ddjoyce2019/Automated-Latte-Art/8B5924DC-6238-43FC-8603-331274C20421_1_106_c.jpeg

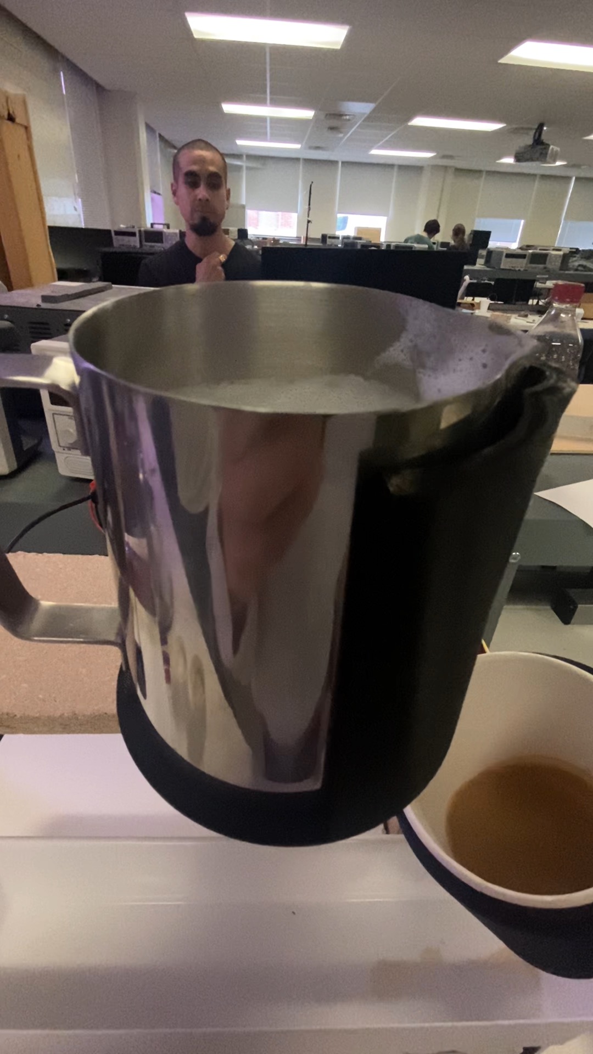
8B5924DC-6238-43FC-8603-331274C20421_1_106_c.jpeg
