ddjoyce2019/Automated-Latte-Art/README.md

# Automated-Latte-Art
Senior Capstone Project: Automated Latte Art Machine
