ddjoyce2019/Automated-Latte-Art/Design Timing.docx

Heart

Tilt Coffee Cup - 30-45 degrees

Lift milk 7-8cm and slowly poor
