ddjoyce2019/Automated-Latte-Art/4.11 Week Plan.docx

**Work on PowerPoint all week whenever is convenient**

*Come in whenever you're available*

MONDAY

- Exhausted exhausted

TUESDAY

- Get heart working til recognizable

WEDNESDAY

- Tulip making blobs

THURSDAY

- Tulip

FRIDAY

- Fern
- GUI

SUNDAY

- Bucket
- Finish fern
- Powerpoint FINISHED

MONDAY

- Demo so hopefully nothing
