ddjoyce2019/Automated-Latte-Art/Flowcharts.pptx

GUI Flowchart

Start

Main Menu

Design One

Design Two

Start

Loading Screen

Run code controlling hardware based on designType

Is hardware program done?

Exit

Has user clicked Design 1 or 2

designType == Design User clicked

End

designType == Design 1

No

Yes

No

Yes

## Slide 2

Actuator Flowchart

Start

Initial actuator location

Signal from GUI received?

Start signal

No

Yes

Exit signal

Actuator 1 Thread

Actuator 2 Thread

End

## Slide 3

Motor Flowchart

Start

Initial position

Signal from GUI received?

Start signal

No

Yes

Exit signal

Servo 1 Thread

Servo 2 Thread

Actuator 1 Thread

Actuator 2 Thread

End
