ddjoyce2019/Automated-Latte-Art/Ideas for Project.docx

- Light following solar pane l- - -
- Recycling sorter - -
- Flood indicator
- Card shuffler and dealer- – - - -
  - Blackjack: can use CV to detect the cards and alert when one player reaches 21 or busts etc
- Phone controlled wheel chair -
- Lie Detector -
- Latte maker- - - - -
- Rubix cube solver– - -
- Coin counter
- Sign language glove- - - - -
- Wire cutter + stripper machine- -
- Card shuffler/dealer
  - Take a deck of cards and shuffle into a predetermined order?
- Latte Maker
  - Create latte art
- Rubix Cube Solver
- Sign Language Glove
  - translate the alphabet

Ask about project manager

Raspberry pi

Purchasing process
