ddjoyce2019/Automated-Latte-Art/Milestone 1.pptx

## Lazy Latte Art

Build a latte art machine by April 17, 2023 for $450
Integrated Systems Design II: Milestone 1 Demo
Elise Ferkler, Mariah Tam, Derrick Joyce, Jackie Bendziewicz, Leah Brown, Luke Swetonic
Electrical and Computer Engineering
Clemson University

## Block Diagram


## GUI Flow Chart

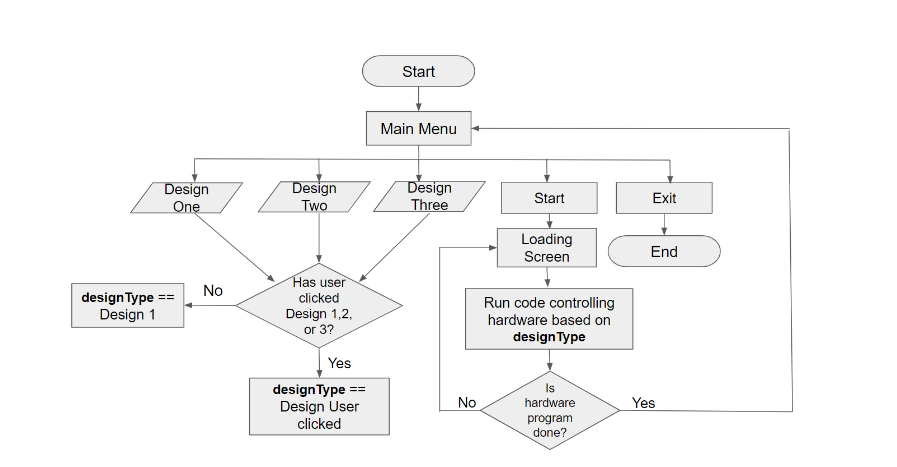
[picture p11: figure]

## Actuator Control Flow Chart

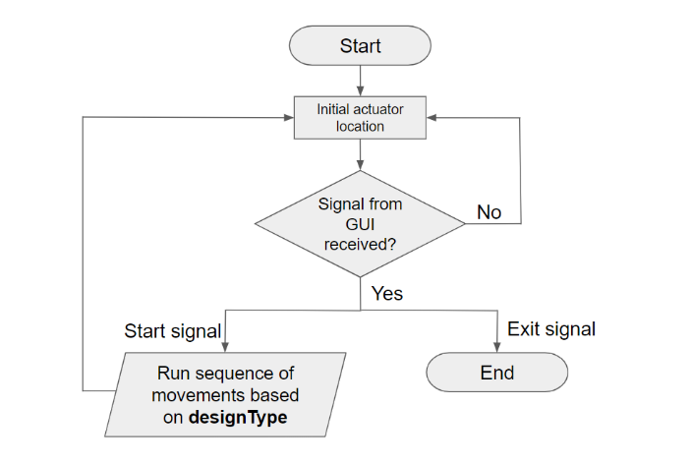
[picture p12: figure]

## Motor Control Flow Chart

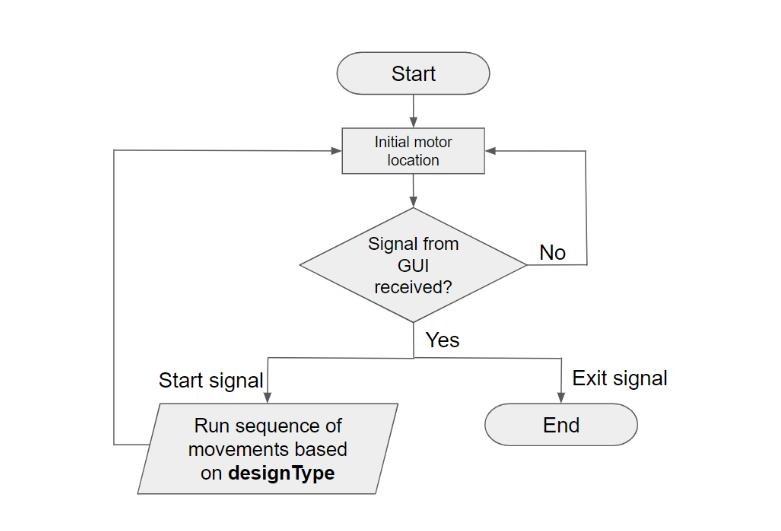
[picture p13: figure]

## Claimed Deliverables

- Create first draft of physical design
- Program the 2 linear actuators and 2 servos to move simultaneously
- Program the coffee cup servo to rotate from 0 to 45 degrees
- Program the milk cup servo to rotate from 0 to 150 degrees
- Program the vertical linear actuator to move up 4 inches
- Program the horizontal linear actuator to move right 3 inches

## Implemented Prototype

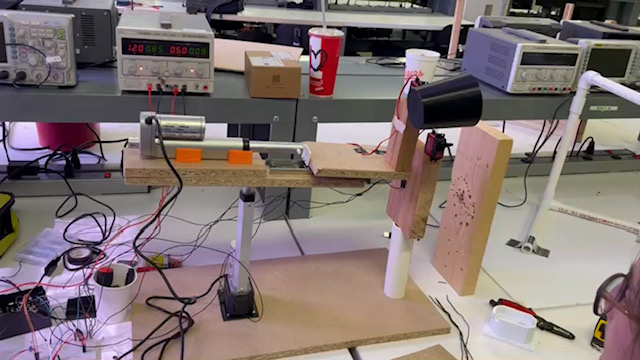
[picture p14: figure]

## Challenges/Bottlenecks

- Twitching servo motors
- Precise control of linear actuators
- Speed of linear actuators
