ddjoyce2019/Automated-Latte-Art/Python Modules.docx

Python Modules

App development

- kivy

Resources:

https://www.section.io/engineering-education/kivy-python-first-app/

https://www.geeksforgeeks.org/kivy-tutorial/

Raspberry Pi Connections

https://medium.com/geekculture/gpio-programming-on-the-raspberry-pi-python-libraries-e12af7e0a812

- RPi.GPIO

Resources:

https://www.ics.com/blog/control-raspberry-pi-gpio-pins-python

https://pythonprogramming.net/gpio-raspberry-pi-tutorials/

-gpiozero
Resources:

https://gpiozero.readthedocs.io/en/stable/

Motor controls

Actuator Controls
