ddjoyce2019/Automated-Latte-Art/Weekly Progress Report - April 10.docx

Intelligent System Design II

Electrical and Computer Engineering

Clemson University

Weekly Progress Report and Planning Sheet

Lazy Latte Art

Leah Brown, Luke Swetonic, Jacqueline Bendziewicz, Mariah Tam, Elise Ferkler, Derrick Joyce

Week of: April 10, 2023

Activities Completed This week (bullet points):

- Integrated GUI
- Stabilized base
- Worked on heart design
- Started work on Tulip design

Student (update) | Individual Accomplishment(s)/Effort(s) contributing to Team Efforts | PMP sync?*
Luke | Helped change the heart design to pour a better design, helped with some physical design issues. | yes
Elise | Helped modify the heart design, helped stabilize physical design, and started fixing Tulip design | yes
Leah | Helped with testing the heart design with coffee and fix program for tulip | yes
Jackie | Helped modify heart design, helped stabilize physical design and fix wires and breadboard in place | yes
Mariah | Integrated the GUI into the design code, helped modify heart design, helped stabilize the physical design. | yes
Derrick | Cut pieces for physical design, helped integrate GUI with hardware code, helped with heart design | yes

* Please answer as Yes, No or Ahead, which represent on-schedule, late and ahead-of-schedule progress with respect to the PMP.

Activities in Progress (bullet points):

- Continue working on heart and tulip designs
- Continue working on casing
- Continue to update GUI

Activities to be Started Next Week (bullet points):

- Finish heart design
- Finish Tulip design
- Work on fern design
- Finish casing for design

Issues for Immediate Action and Attention (bullet points):

Materials and Supplies Needed (bullet points):

- Tablet for GUI
