ddjoyce2019/Automated-Latte-Art/BOM-team 4.xlsx

Item (brief description in 2-5 words) | Quantity | Price/Unit | Net Price | Link (please hit enter in this field after pasting the link here and please make sure that the link is clickable)
Linear Actuator (6in) | 1 | $42.99 | $42.99 | https://www.amazon.com/ECO-WORTHY-330lbs-Tracker-Actuator-Multi-function/dp/B00NM8H5VO
Linear Actuator (4in) | 1 | $41.99 | $41.99 | https://www.amazon.com/ECO-WORTHY-330lbs-Tracker-Actuator-Multi-function/dp/B00NM8H6VS
Sliders | 2 | $10.99 | $21.98 | https://www.amazon.com/dp/B06WW7G7X4?ref_=cm_sw_r_apin_dp_J738695WCKWJVB6W70ZE
DC Servo Motors | 1 | $35.99 | $35.99 | https://www.amazon.com/dp/B08739MGPL?s=toys-and-games&sp_csd=d2lkZ2V0TmFtZT1zcF9kZXRhaWxfdGhlbWF0aWM
Nespresso Pods (Coffee Pods) | 1 | $47.99 | $47.99 | https://www.amazon.com/Nespresso-Aluminum-Capsules-Distinctive-Compatible/dp/B07KWYLDP1
DC Motor with Encoder | 1 | $29.00 | $29.00 | https://www.digikey.com/en/products/detail/dfrobot/FIT0403/6588578
Raspberry Pi |  |  | 0
 |  |  | 0
 |  |  | 0
 |  |  | 0
 |  |  | 0
 |  |  | 0
 |  | Total | $219.94
(NOTE1) Please try to group together items from the same vendor in subsequent rows.
(NOTE2) If there are more than 10 items in your BOM, that is fine. In this case, please freel free to add more rows.
(NOTE3) You are welcome to import this sheet in Google Sheets and work on it. However, please email me an excel file by downloading your Google sheet.
