ddjoyce2019/Automated-Latte-Art/BUDGET.xlsx

Item | Cost | Cost Per Person | Link
Paper Cups | $14.97 | $2.50 | https://www.amazon.com/gp/product/B09DNS3Y37/ref=sw_img_1?smid=A1EPQ3W76BWAS3&th=1
Espresso Pods | $33.33 | $5.55
Paper Cups again | $14.97 | $2.50
 | total | $10.54
White board | $13.98 | $2.33
 | elise | $8.21
