ddjoyce2019/Automated-Latte-Art/cup holder feb 9.stl

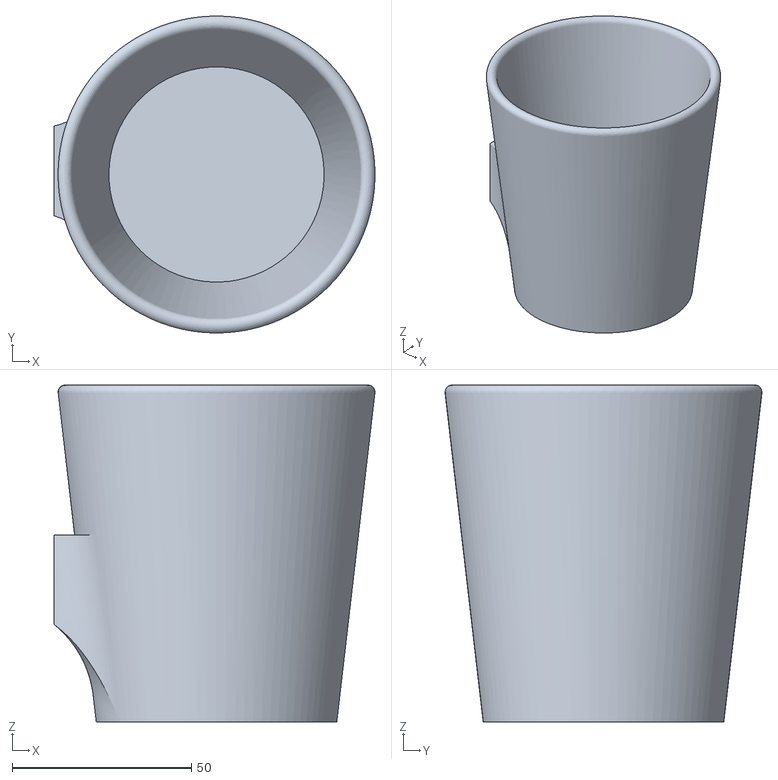
[picture p35: CAD file, 2024-06-03]
cup holder feb 9.stl
89.5 x 88.4 x 94.0
