ddjoyce2019/Automated-Latte-Art/Peer Eval Changes.docx

- Made capitalization of words like Python and Raspberry Pi uniform throughout the report.
- Added definitions for abbreviations at first use of them such as Graphical User Interface.
- Updated citation to use [#] rather than #.
- Separated Post mortem into the 3 subsections rather than 1 long essay.
- Added Image of our final design.
- Added Image of GUI Main Menu and updated figure numbers
- Improved grammar on several sentences
